connormichalec/Universal-Gesture-Interface/PCBs/finalboard/V2/finalboard_v2.kicad_pcb

## KiCad design PCBs/finalboard/V2/finalboard_v2.kicad_pcb (2026-03-28)

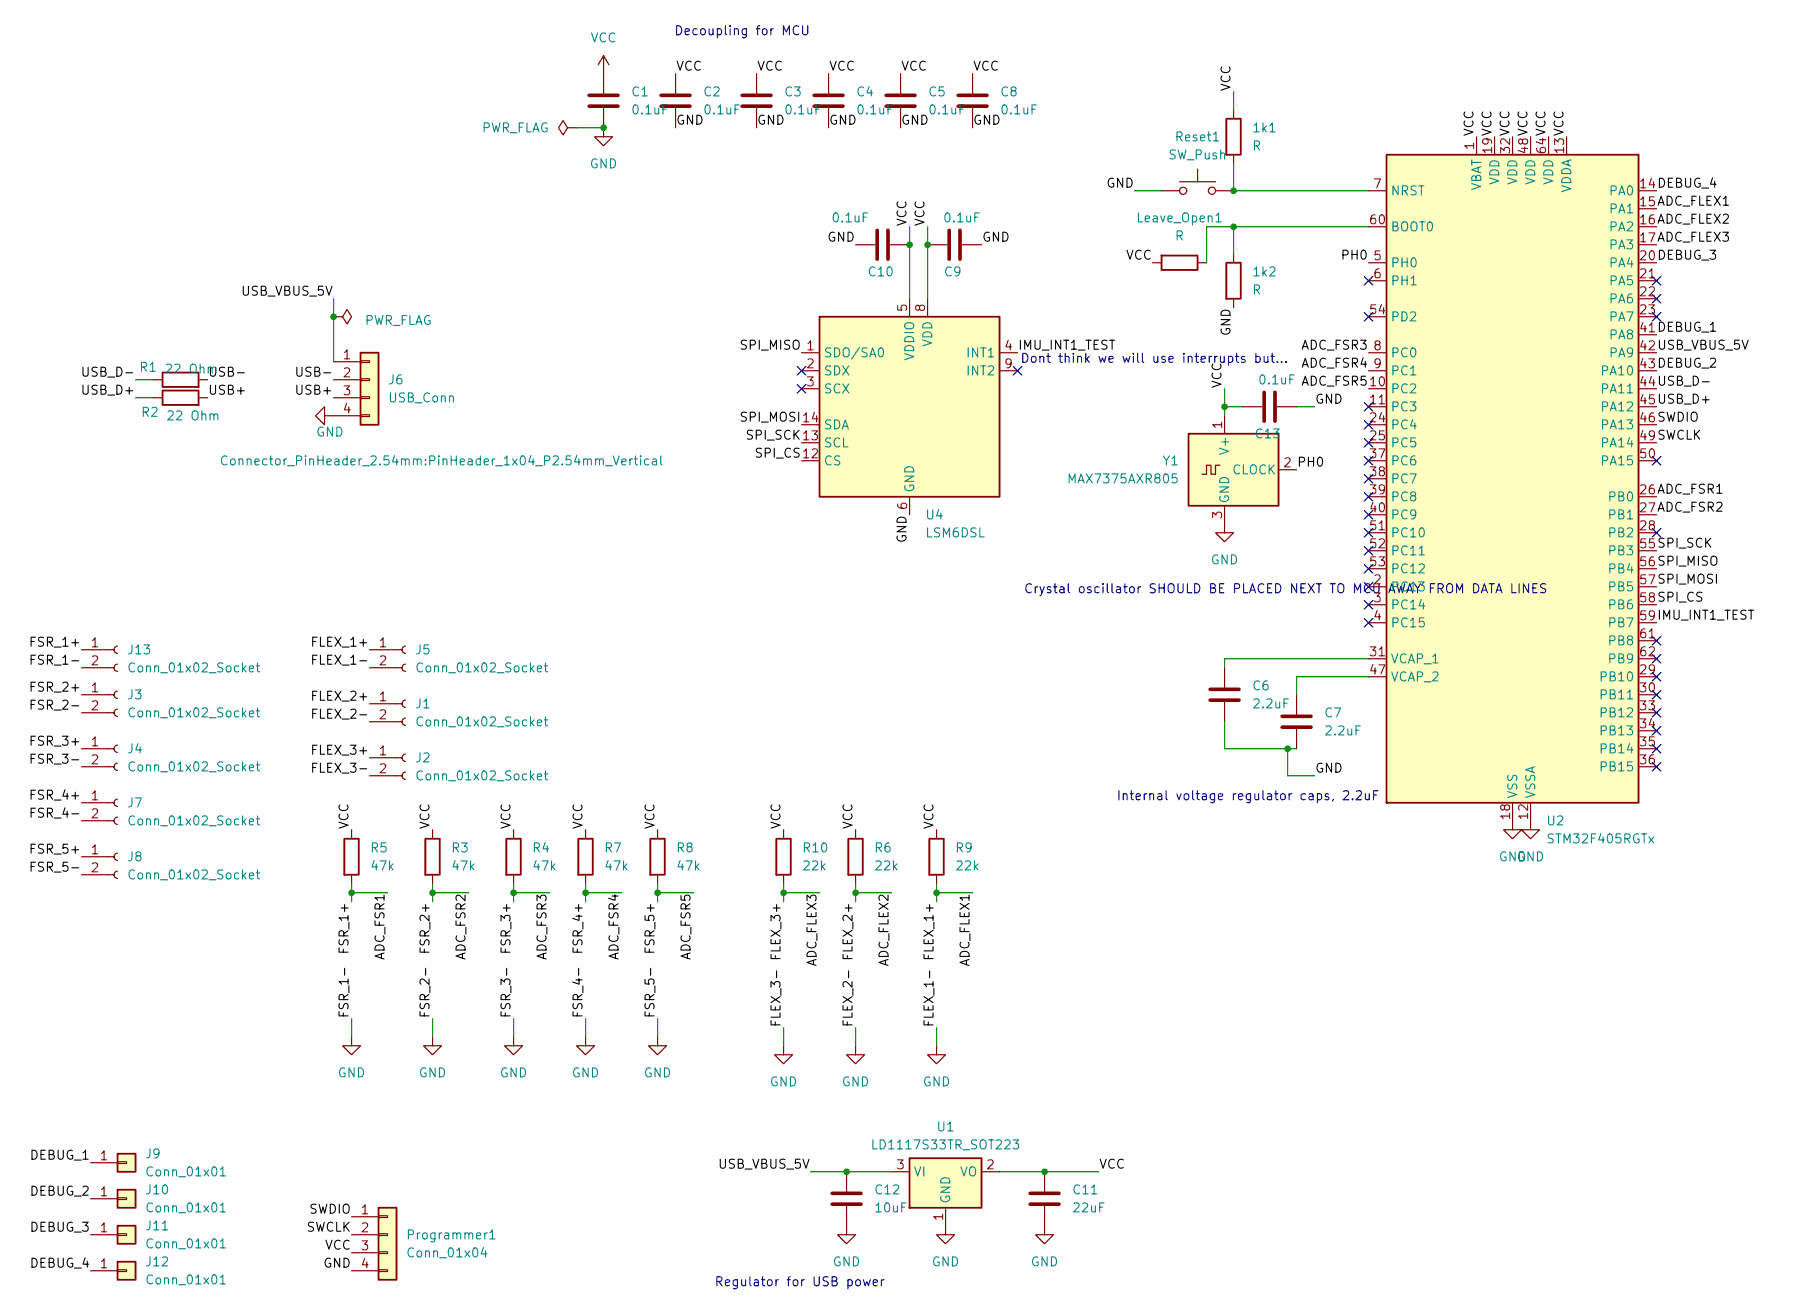
[picture p1: schematic finalboard_v2.kicad_sch]

Parts:
1k1, 1k2: R; R_0603_1608Metric_Pad0.98x0.95mm_HandSolder
C1, C2, C3, C4, C5, C8, C9, C10, C13: 0.1uF; C_0603_1608Metric_Pad1.08x0.95mm_HandSolder
C6, C7: 2.2uF; C_0603_1608Metric_Pad1.08x0.95mm_HandSolder
C11: 22uF; C_0603_1608Metric_Pad1.08x0.95mm_HandSolder
C12: 10uF; C_0603_1608Metric_Pad1.08x0.95mm_HandSolder
J1, J2, J3, J4, J5, J7, J8, J13: Conn_01x02_Socket; PinHeader_1x02_P2.54mm_Vertical
J6: USB_Conn; PinHeader_1x04_P2.54mm_Vertical
J9, J10, J11, J12: Conn_01x01; TestPoint_Pad_1.5x1.5mm
Leave_Open1: R; R_Axial_DIN0204_L3.6mm_D1.6mm_P7.62mm_Horizontal
Programmer1: Conn_01x04; PinHeader_1x04_P2.54mm_Vertical
R1, R2: 22 Ohm; R_0603_1608Metric_Pad0.98x0.95mm_HandSolder
R3, R4, R5, R7, R8: 47k; R_0603_1608Metric_Pad0.98x0.95mm_HandSolder
R6, R9, R10: 22k; R_0603_1608Metric_Pad0.98x0.95mm_HandSolder
Reset1: SW_Push; SW_PUSH_6mm_H4.3mm
U1: LD1117S33TR_SOT223; SOT-223-3_TabPin2
U2: STM32F405RGTx; LQFP-64_10x10mm_P0.5mm
U4: LSM6DSL; LGA-14_3x2.5mm_P0.5mm_LayoutBorder3x4y
Y1: MAX7375AXR805; SOT-323_SC-70

Connections:
/ADC_FLEX1: J5.1, R9.2, U2.15 (PA1)
/ADC_FLEX2: J1.1, R6.2, U2.16 (PA2)
/ADC_FLEX3: J2.1, R10.2, U2.17 (PA3)
/ADC_FSR1: J13.1, R5.2, U2.26 (PB0)
/ADC_FSR2: J3.1, R3.2, U2.27 (PB1)
/ADC_FSR3: J4.1, R4.2, U2.8 (PC0)
/ADC_FSR4: J7.1, R7.2, U2.9 (PC1)
/ADC_FSR5: J8.1, R8.2, U2.10 (PC2)
/DEBUG_1: J9.1, U2.41 (PA8)
/DEBUG_2: J10.1, U2.43 (PA10)
/DEBUG_3: J11.1, U2.20 (PA4)
/DEBUG_4: J12.1, U2.14 (PA0)
/IMU_INT1_TEST: U2.59 (PB7), U4.4 (INT1)
/PH0: U2.5 (PH0), Y1.2 (CLOCK)
/SPI_CS: U2.58 (PB6), U4.12 (CS)
/SPI_MISO: U2.56 (PB4), U4.1 (SDO/SA0)
/SPI_MOSI: U2.57 (PB5), U4.14 (SDA)
/SPI_SCK: U2.55 (PB3), U4.13 (SCL)
/SWCLK: Programmer1.2, U2.49 (PA14)
/SWDIO: Programmer1.1, U2.46 (PA13)
/USB+: J6.3, R2.2
/USB-: J6.2, R1.2
/USB_D+: R2.1, U2.45 (PA12)
/USB_D-: R1.1, U2.44 (PA11)
/USB_VBUS_5V: C12.1, J6.1, U1.3 (VI), U2.42 (PA9)
GND: 1k2.2, C1.2, C2.2, C3.2, C4.2, C5.2, C6.2, C7.2, C8.2, C9.2, C10.1, C11.2, C12.2, C13.2, J1.2, J2.2, J3.2, J4.2, J5.2, J6.4, J7.2, J8.2, J13.2, Programmer1.4, Reset1.1, U1.1 (GND), U2.12 (VSSA), U2.18 (VSS), U2.63 (VSS), U4.6 (GND), U4.7 (GND), Y1.3 (GND)
unnamed: 1k2.1, Leave_Open1.1, U2.60 (BOOT0)
unnamed: 1k1.2, Reset1.2, U2.7 (NRST)
unnamed: C6.1, U2.31 (VCAP_1)
unnamed: C7.1, U2.47 (VCAP_2)
VCC: 1k1.1, C1.1, C2.1, C3.1, C4.1, C5.1, C8.1, C9.1, C10.2, C11.1, C13.1, Leave_Open1.2, Programmer1.3, R3.1, R4.1, R5.1, R6.1, R7.1, R8.1, R9.1, R10.1, U1.2 (VO), U2.1 (VBAT), U2.13 (VDDA), U2.19 (VDD), U2.32 (VDD), U2.48 (VDD), U2.64 (VDD), U4.5 (VDDIO), U4.8 (VDD), Y1.1 (V+)

Notes on the sheet:
Regulator for USB power
Internal voltage regulator caps, 2.2uF
Decoupling for MCU
Crystal oscillator SHOULD BE PLACED NEXT TO MCU AWAY FROM DATA LINES
Dont think we will use interrupts but...

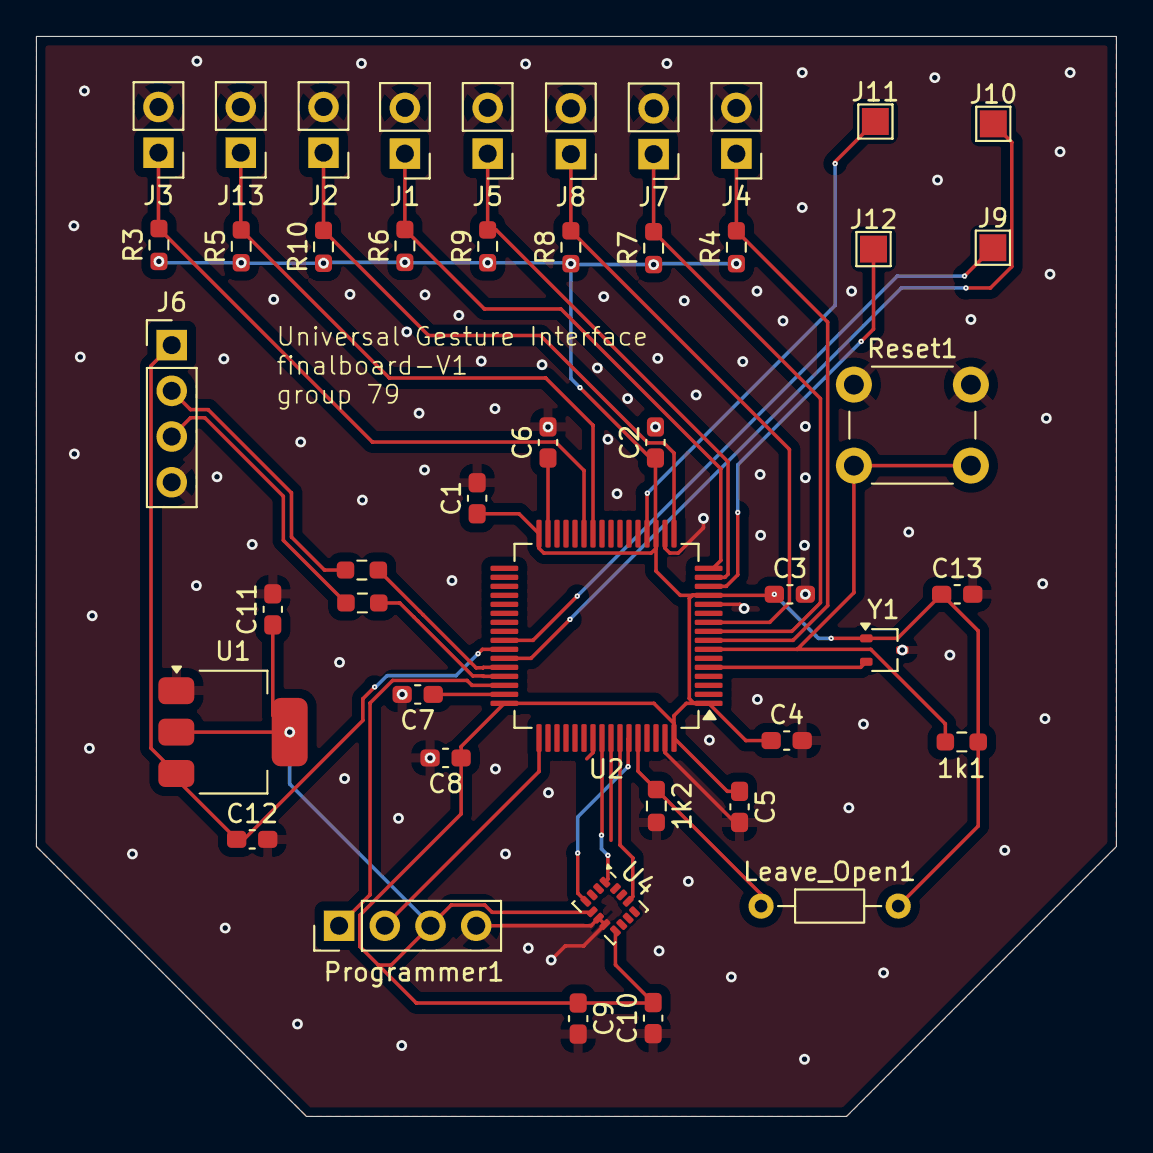
[picture p2: board finalboard_v2.kicad_pcb from above]

Board: 2 copper layers, 60.0 x 60.0 mm, 45 parts (0 on the bottom side), 31 nets.
