connormichalec/Universal-Gesture-Interface/STM32/universal_gesture_interface/Core/Src/main.c

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
/* Includes ------------------------------------------------------------------*/
#include "main.h"
#include "usb_device.h"

/* USER CODE BEGIN Includes */
#include "imu.h"
#include "motion_processing.h"
#include "flex_sensor.h"
#include "utils.h"
#include "static_gesture.h"
#include "dynamic_gesture.h"
#include "communication.h"
#include "keyboard_mouse.h"
/* USER CODE END Includes */

ADC_HandleTypeDef hadc1;
ADC_HandleTypeDef hadc2;
ADC_HandleTypeDef hadc3;
DMA_HandleTypeDef hdma_adc1;
DMA_HandleTypeDef hdma_adc2;
DMA_HandleTypeDef hdma_adc3;

SPI_HandleTypeDef hspi1;

/* USER CODE BEGIN PV */

// Sensor state variables
float raw_accel[3] = { 0, 0, 0 };
float total_accel[3] = { 0, 0, 0 };
float accel[3] = { 0, 0, 0 };
float grav[3] = { 0, 0, -1 };
float gyro[3] = { 0, 0, 0 };
float vel[3] = { 0, 0, 0 };
float flex_thumb = 0;
float flex_index = 0;
float flex_middle = 0;

StaticGesture current_gesture = NONE;

/* USER CODE END PV */

void SystemClock_Config(void);
static void MX_GPIO_Init(void);
static void MX_DMA_Init(void);
static void MX_ADC1_Init(void);
static void MX_ADC2_Init(void);
static void MX_SPI1_Init(void);
static void MX_ADC3_Init(void);
/**
  * @brief  The application entry point.
  * @retval int
  */
int main(void)
{

  /* MCU Configuration--------------------------------------------------------*/

  /* Reset of all peripherals, Initializes the Flash interface and the Systick. */
  HAL_Init();

  /* Configure the system clock */
  SystemClock_Config();

  /* Initialize all configured peripherals */
  MX_GPIO_Init();
  MX_DMA_Init();
  MX_ADC1_Init();
  MX_ADC2_Init();
  MX_SPI1_Init();
  MX_USB_DEVICE_Init();
  MX_ADC3_Init();
  /* USER CODE BEGIN 2 */


  volatile uint16_t flex_reg1 = 0;				// Thumb
  volatile uint16_t flex_reg2[2] = { 0, 0 };	// Index, middle
  volatile uint16_t fsr_reg[3] = { 0, 0, 0 };	// Thumb, index, middle
  IMU_Init(&hspi1);
  HAL_ADC_Start_DMA(&hadc1, (uint32_t*)(&flex_reg1), 1);
  HAL_ADC_Start_DMA(&hadc2, (uint32_t*)flex_reg2, 2);
  HAL_ADC_Start_DMA(&hadc3, (uint32_t*)fsr_reg, 3);



  float lp_vel[3] = { 0, 0, 0 };
  float prev[3] = { 0, 0, 0 };
  float hp[3] = { 0, 0, 0 };

  uint32_t prev_timestamp = 0;
  uint32_t current_timestamp = 0;
  uint32_t dt = 0;
  char buf[64];		// Temp, just for debug outputs

  uint32_t tick;


  // Event handlers
  PeriodicEventHandler sendUpdates = NewPeriodicEvent(10);
  PeriodicEventHandler pollUpdate = NewPeriodicEvent(1);
  StaticEventHandler fingerGunHandler = NewStaticEventHandler();
  StaticEventHandler thumbsUpHandler = NewStaticEventHandler();
  StaticEventHandler thumbsMiddleHandler = NewStaticEventHandler();
  StaticEventHandler thumbsDownHandler = NewStaticEventHandler();
  SpikeTrigger bangHandler = NewSpikeTrigger(0.05, 0.8);

  /* USER CODE END 2 */

  /* Infinite loop */
  /* USER CODE BEGIN WHILE */
  while (1)
  {
	 tick = HAL_GetTick();


	while (shouldTick(tick, &pollUpdate)) {
		// Get elapsed time since last tick
		current_timestamp = tick;
		dt = current_timestamp - prev_timestamp;
		prev_timestamp = current_timestamp;

		// Read IMU values and rotate
		IMU_ReadAccel(&hspi1, raw_accel);
		IMU_ReadGyro(&hspi1, gyro);

		// Rotate to cancel out effect of rotated IMU
		RotateData(&raw_accel[0], &raw_accel[1]);
		RotateData(&gyro[0], &gyro[1]);

		// Testing out filtering
		AccelLPF(raw_accel, total_accel, 0.5);

		// Gravity calculation
		RotateGravity(grav, gyro, 0.001);
		StabilizeGravity(grav, total_accel, 0.1);

		// Subtract gravity from acceleration
		accel[0] = total_accel[0] - grav[0];
		accel[1] = total_accel[1] - grav[1];
		accel[2] = total_accel[2] - grav[2];

		AccelToVel(accel, vel, 0.98, 0.001f);
		VelLPF(vel, lp_vel, 0.25);

		// Record and remap flex sensor values
		//	- Remapping values determined from personal tests/recordings. May vary based on hardware
		float flex_thumb_raw = FlexRemap(flex_reg1, 985, 1075);
		float flex_index_raw = FlexRemap(flex_reg2[0], 2300, 950);
		float flex_middle_raw = FlexRemap(flex_reg2[1], 1800, 550);

		// Apply lpf to flex sensor values
		FlexLPF(flex_thumb_raw, &flex_thumb, 0.05);
		FlexLPF(flex_index_raw, &flex_index, 0.05);
		FlexLPF(flex_middle_raw, &flex_middle, 0.05);


		// Handle static gestures
		if (should_trigger_gesture(&fingerGunHandler, is_finger_gun())) {
			current_gesture = FINGER_GUN;
			send_gesture_msg(FINGER_GUN);
		}

		if (should_trigger_gesture(&thumbsUpHandler, is_thumbs_up())) {
			current_gesture = THUMBS_UP;
			send_gesture_msg(THUMBS_UP);
		}

		if (should_trigger_gesture(&thumbsMiddleHandler, is_thumbs_middle())) {
			current_gesture = THUMBS_MIDDLE;
			send_gesture_msg(THUMBS_MIDDLE);
		}

		if (should_trigger_gesture(&thumbsDownHandler, is_thumbs_down())) {
			current_gesture = THUMBS_DOWN;
			send_gesture_msg(THUMBS_DOWN);
		}

		if (should_trigger_spike_event(&bangHandler, gyro[2] * 0.001)) {
			send_gesture_msg(BANG);
		}
	}


	// Send sensor updates at 100Hz
	while (shouldTick(tick, &sendUpdates)) {
		SensorUpdatePacket msg;
		msg.topic = 0;
		msg.accel_x = lp_vel[0];
		msg.accel_y = lp_vel[1];
		msg.accel_z = lp_vel[2];
		msg.grav_x = grav[0];
		msg.grav_y = grav[1];
		msg.grav_z = grav[2];
		msg.gyro_x = gyro[0];
		msg.gyro_y = gyro[1];
		msg.gyro_z = gyro[2];
		msg.flex_thumb = flex_thumb;
		msg.flex_index = flex_index;
		msg.flex_middle = flex_middle;
		msg.fsr_thumb = fsr_reg[0];
		msg.fsr_index = fsr_reg[1];
		msg.fsr_middle = fsr_reg[2];

		memcpy(buf, &msg, sizeof(msg));

		//USBD_HID_SendRaw(&hUsbDeviceFS, (uint8_t*)buf, sizeof(buf));


		//int8_t mouseReport[4] = {0, (int8_t) {vel[0] * 8000.0f}, (int8_t) {vel[1] * 8000.0f}, 0};
		//USBD_HID_SendReport(&hUsbDeviceFS, mouseReport, 4);


		//Basic mouse and keyboard test:
		// for testing

		// AUTO RELEASE:
		//HID_Task(); // call this every time, makes HID_SendKey automatically release.
		// Trigger keypress
		//HID_SendKey(KEY_MOD_LSHIFT, KEY_A); //sends key as fast as possible without blocking

		//OR: Manually trigger press/release:
		//HID_KeyPress(0, KEY_W);
		//HAL_Delay(15);
		//HID_KeyRelease();
		//HAL_Delay(15);
		// Send mouse movement:
		HID_SendMouse(0, 1, 1, 0);

		/* FOR HID DATA SEND:*/
		// Send a string
		char message[63];
		sprintf(message, "balls");
		USBD_HID_SendRaw(&hUsbDeviceFS, (uint8_t*)message, strlen(message));

		// Or send raw bytes
		//uint8_t data[] = {0xAB, 0xCD, 0xEF};
		//USBD_HID_SendRaw(&hUsbDeviceFS, data, sizeof(data));
	}


	//WHOAMI response test:

    /*uint8_t tx[2] = {0x8F, 0x00};   //WHOAMI/Dummy byte
  	uint8_t rx[2];
    CS_LOW();
    HAL_SPI_TransmitReceive(&hspi1, tx, rx, 2, HAL_MAX_DELAY);
    CS_HIGH();

    sprintf(buf, "IMU HWOAMI resp: %02X\r\n", rx[1]);
    CDC_Transmit_FS((uint8_t*)buf, strlen(buf));*/

    //sprintf(buf, "%d\r\n", fsr_reg);
    //CDC_Transmit_FS((uint8_t*)buf, strlen(buf));

    /* USER CODE END WHILE */

    /* USER CODE BEGIN 3 */
  }
  /* USER CODE END 3 */
}

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
