connormichalec/Universal-Gesture-Interface/STM32/universal_gesture_interface/Core/Inc/motion_processing.h

/*
 * motion_processing.h
 *
 *  Created on: Apr 1, 2026
 *      Author: kobes
 */

#include "stm32f4xx_hal.h"

#ifndef INC_MOTION_PROCESSING_H_
#define INC_MOTION_PROCESSING_H_

void RotateData(float* x, float* y);
void AccelLPF(float* raw_data, float* accel, float alpha);
void HPF(float* accel, float* prev, float* hp, float alpha);
void AccelToVel(float* accel, float* vel, float drag, float dt);
void VelLPF(float* vel, float* lp_vel, float alpha);
void RotateGravity(float* grav, float* gyro, float dt);
void StabilizeGravity(float* grav, float* accel, float alpha);

#endif /* INC_MOTION_PROCESSING_H_ */
