connormichalec/Universal-Gesture-Interface/(commit log)

2026-02-19 Testboard schematic finished, needs layout
    [testboard_v1.kicad_pcb, testboard_v1.kicad_sch]
2026-02-20 V1 layout done (its kinda crappy tho)
    [testboard_v1.kicad_pcb]
2026-02-20 V2 pcb schematic done - switched IMU. needs layout from kenobi
    [testboard_v2.kicad_pcb, testboard_v2.kicad_sch]
2026-02-24 V2 updated for USB
    [testboard_v2.kicad_pcb, testboard_v2.kicad_sch]
2026-02-25 V2 schematic done - awaiting layout from kenobi
    [testboard_v2.kicad_pcb, testboard_v2.kicad_sch]
2026-03-12 Finalboard schematic done, awaiting layout from kenboi
    [finalboard_v1.kicad_pcb, finalboard_v1.kicad_sch]
2026-03-13 Finalboard-V1 layout done (by kenobi)
    [finalboard_v1.kicad_pcb, finalboard_v1.kicad_sch, testboard_v2.kicad_pcb]
2026-03-26 upload stm32 project
2026-03-28 Basic ADC working
2026-03-28 ping test for imu works (frankenstein pcb)
    [finalboard_v2.kicad_pcb, finalboard_v2.kicad_sch]
2026-03-28 Edit finalboard v2 to fix pinout on imu
    [finalboard_v2.kicad_pcb, finalboard_v2.kicad_sch]
2026-03-29 Update README with final board development details
    Added a new section for the final board development and updated the existing content for clarity and organization.
2026-03-29 Document test board assembly and initial configuration
    Added new entries for test board assembly and configuration, detailing the soldering process and initial tests.
2026-03-29 IMU tests working! (on frankenstein)
2026-03-30 Revise README with project updates and milestones
    Updated README to include new project developments and milestones from February to March 2026, detailing the progress on the Universal Gesture Interface project, including PCB schematics, assembly, USB connectivity, and IMU integration.
2026-04-01 Adding filtering, currently can't test due to broken(?) hardware
    [main.c, motion_processing.c, motion_processing.h]
2026-04-06 Polished up mouse movement, flex sensor is low passed and now triggers scrolling
    [flex_sensor.c, flex_sensor.h, main.c, main.py, motion_processing.c, motion_processing.h, universal_gesture_interface_test.ioc]
2026-04-26 Basic gesture detection framework, all sensor data good
2026-04-28 Working on velocity integration, new message protocol
